trex2000/WifiBot/Academy Generated Requirement Specifications from Reqview/RC.html

# rc car

ID | Description | Discussion | Links
1 | 1 General Requirements Requirments describing the Robot
21 | 1.1 System Requirements Required features of the Robot | 2015-06-25: 123
17 | 1.1.1 Movement - Customer will provide chassis for the robot - Forward - Backward
24 | 1.1.1.1 Speed The speed of the engines will be variable starting from 0%, until 100%
25 | 1.1.1.1.1 Acceleration - incrementing 1% in every 100 milliseconds, the duty cycle will increase his value until 100% | 2015-06-25: My comment
26 | 1.1.1.1.2 Break - decrementing 2% in every 100 milliseconds, the duty cycle will decrease his value until 0%
27 | 1.1.1.1.3 No command - decrementing 1% in evert 100 milliseconds, the duty cycle will decrease his value until 0%
18 | 1.1.2 Direction The robot will have to perform the following movements: - Steering Left - Steering Right
28 | 1.1.2.1 Steering Left - while steering left is in action, the speed of the motor should be constant and equal to the current value
29 | 1.1.2.2 Steering Right - while steering right is in action, the speed of the motor should be constant and equal to the current value
23 | 1.1.3 Interface with ESP8266 The command will be sent form a web browser running on a separate Wifi module ESP8266
33 | 1.1.3.1 Communication The communication between the 2 modules (ESP8266 and Arduino UNO) will be performed through 4 separate GPIO port, each port corresponding to a direction (UP, DOWN, LEFT, RIGHT)
19 | 1.1.4 Signaling The robot will be equipped with 2 flashers on each side
30 | 1.1.4.1 Pulse generation - while steering left/right, the left/right signaling should activate, indicating the direction of the new path
31 | 1.1.4.2 Rhytm - 340 milliseconds on - 420 milliseconds off
20 | 1.1.5 Lighting The robot will be equipped with 2 LED lights that will be turned on when the light sensors status indicates DARK, will be switched off in case the light sensors indicate LIGHT
32 | 1.1.5.1 Light sensors - the robot will have a light sensor which will convert the light levels to a voltage with a range of 0-5 volts
14 | 1.2 Software Requirements Requirments related to software design and implementation
54 | 1.2.1 Hardware Abstraction Layer - will give the input/output functions to aplication
56 | 1.2.1.1 Inputs
59 | 1.2.1.1.1 SIA_LightSensor - range: 0 - 1023 - default value: 1023
60 | 1.2.1.1.2 SID_WifiControlUp - range: 0 - 1 - default value: 0
61 | 1.2.1.1.3 SID_WifiControlDown - range: 0 - 1 - default value: 0
62 | 1.2.1.1.4 SID_WifiControlRight - range: 0 - 1 - default value: 0
63 | 1.2.1.1.5 SID_WifiControlLeft - range: 0 - 1 - default value: 0
57 | 1.2.1.2 Outputs
64 | 1.2.1.2.1 SOD_Motor12_0 - range : 0 - 1 - default value: 0
65 | 1.2.1.2.2 SOD_Motor12_1 - range : 0 - 1 - default value: 0
66 | 1.2.1.2.3 SOD_Motor12_2 - range : 0 - 1 - default value: 0
67 | 1.2.1.2.4 SOD_Motor12_3 - range : 0 - 1 - default value: 0
68 | 1.2.1.2.5 SODPWM_EnableMotor1 - range : 0 - 100 (%) - default value: 0
69 | 1.2.1.2.6 SODPWM_EnableMotor2 - range : 0 - 100 (%) - default value: 0
70 | 1.2.1.2.7 SOD_LeftFlasher -range: 0 - 1 -default value : 0
71 | 1.2.1.2.8 SOD_RightFlasher -range: 0 - 1 -default value : 0
72 | 1.2.1.2.9 SOD_LowBeam -range: 0 - 1 -default value: 0
58 | 1.2.1.3 Functional requirements
92 | 1.2.1.3.1 Buffering The inputs and outputs will be placed inside 2 buffers, called inputBuffers and outputBuffers.
93 | 1.2.1.3.2 Interfaces 2 Interfaces shall be implemented between the APP <-> HAL: - A get() interface, which will be used to return the value of a logical pin (as described in chapter 1.2.1.1) - A set() interface, which will be used to set a request from the APP layer towards the HAL layer to update the physical output corresponding to the logical port, as described in chapter 1.2.1.2.
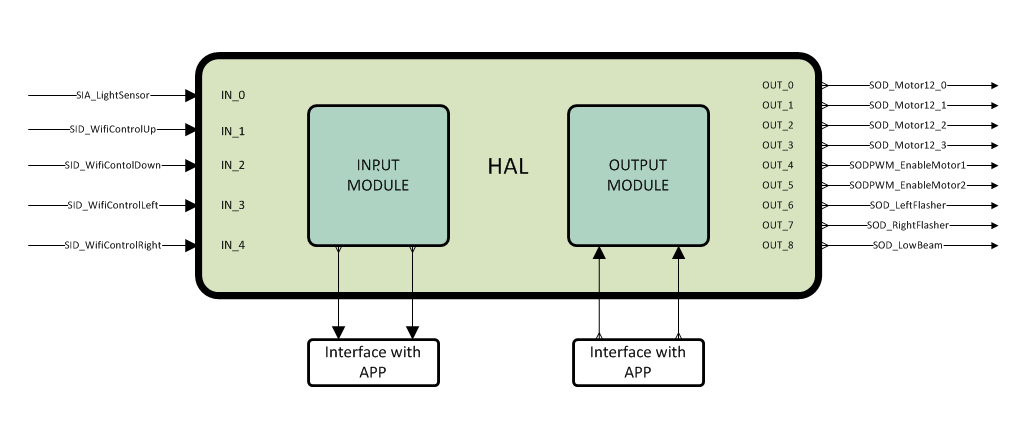
[picture p1: Academy Generated Requirement Specifications from Reqview/RC_files/80_1_hal.PNG]
80 | 1.2.1.4 Hardware Abstraction Layer  80_1_hal.PNG
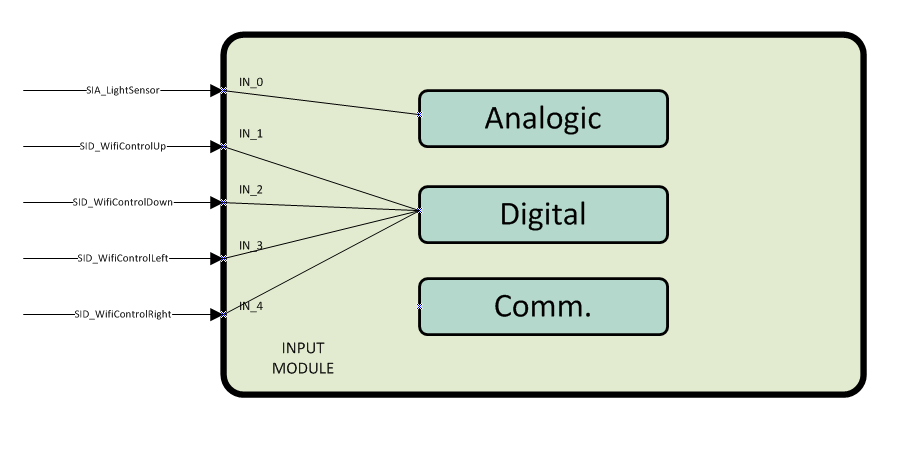
[picture p2: Academy Generated Requirement Specifications from Reqview/RC_files/81_1_input.PNG]
81 | 1.2.1.4.1 Inputs  81_1_input.PNG
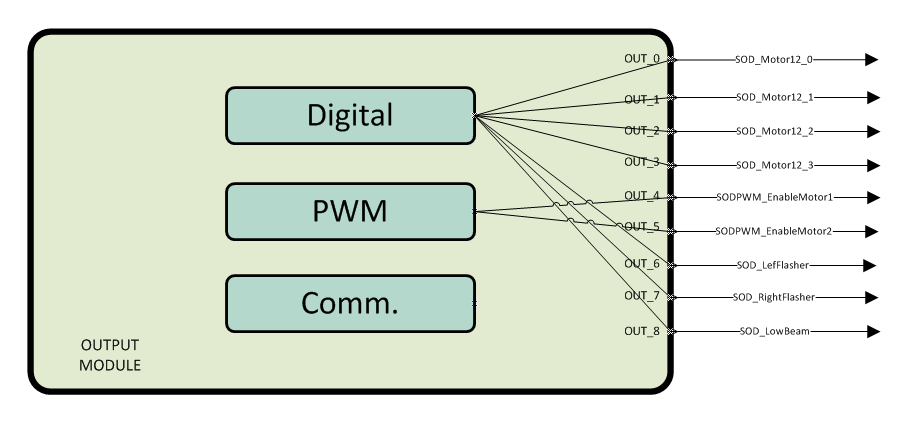
[picture p3: Academy Generated Requirement Specifications from Reqview/RC_files/82_1_output.PNG]
82 | 1.2.1.4.2 Outputs  82_1_output.PNG
76 | 1.2.2 Hardware Software Interface
77 | 1.2.2.1 Inputs SIA_Light Sensor – Arduino.A0 SID_WifiControlUp – Arduino.D7 SID_WifiControlDown – Arduino.D8 SID_WifiControlLeft – Arduino.D12 SID_WifiControlRight –Arduino.D13
78 | 1.2.2.2 Outputs SOD_Motor12_0 – Arduino.D10 SOD_Motor12_1 – Arduino.D9 SOD_Motor12_2 – Arduino.D5 SOD_Motor12_3 – Arduino.D4 SODPWM_EnableMotor1 – Arduino.D11 PWM SODPWM_EnableMotor2 – Arduino.D3 PWM SOD_LeftFlasher – Arduino.A2 ( must be set a digital pin) SOD_RightFlasher – Arduino.A1 ( must be set a digital pin) SOD_LowBeam – Arduino.D6
55 | 1.2.3 Application Software
11 | 1.3 Hardware Requirements All requirments related to: - hardware schematic - wiring - PCB design
36 | 1.3.1 Hardware Schematic
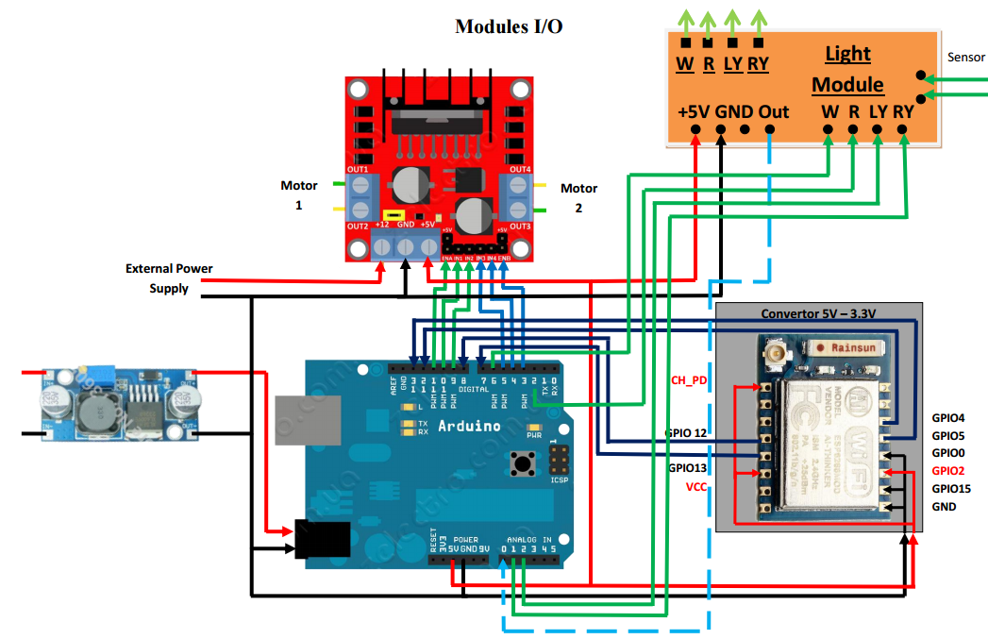
[picture p4: Academy Generated Requirement Specifications from Reqview/RC_files/37_1_wiring.png]
37 | 1.3.2 Wiring  37_1_wiring.png
38 | 1.3.3 PCB Design
39 | 1.3.4 Modules Informations regarding the modules used in project: - DC - DC Module - Arduino Module - ESP8266 Wi Fi module - Hbridge Module - Light Module
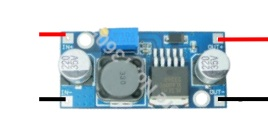
[picture p5: Academy Generated Requirement Specifications from Reqview/RC_files/40_1_dc-dc.jpg]
40 | 1.3.4.1 DC - DC Module  40_1_dc-dc.jpg
41 | 1.3.4.1.1 Inputs RED WIRE – The positive wire of the power supply BLACK WIRE – The ground wire of the power supply
43 | 1.3.4.1.2 Outputs RED WIRE – The positive wire for the 12V power circuit BLACK WIRE – The ground wire for the 12V power circuit
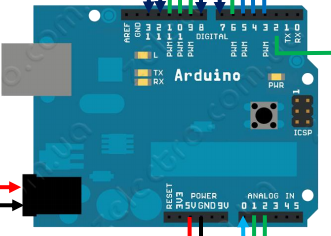
[picture p6: Academy Generated Requirement Specifications from Reqview/RC_files/44_1_arduino.jpg]
44 | 1.3.4.2 Arduino Uno Module  44_1_arduino.jpg
45 | 1.3.4.2.1 Inputs A0 – the value of the light sensor D7 – connects the GPIO13 pin of the Wi Fi module to the Arduino (Future Up button) D8 – connects the GPIO12 pin of the Wi Fi module to the Arduino (Future Down button) D12– connects the GPIO4 pin of the Wi Fi module to the Arduino (Future Left button) D13– connects the GPIO5 pin of the Wi Fi module to the Arduino (Future Right button) The power needed for powering the module will be provided from the DC – DC module output

46

1.3.4.2.2 Outputs

5V – power for the Wi – Fi Conversion module which will privide 3.3V for the pins: VCC, CH_PD and GPIO2

GND – ground reference for the Wi – Fi module pins: GPIO0, GPIO15 and GND

Analog pin 1 – connects with the RY pin on the Light Module,but it has to be set as a DIGITAL PIN

Analog pin 2 – connects with the LY pin on the Light Module,but it has to be set as a DIGITAL PIN

Digital pin 2 – connects with the R pin on the Light Module

Digital pin 3 – connects with the ENB pin on the Hbridge Module, this pin needs to be a PWM pin.

Digital pin 4 – connects with the Hbridge pin IN4, is not necessarly to be a pwm pin.

Digital pin 5 – connects with the Hbridge pin IN3, is not necessarly to be a pwm pin.

Digital pin 6 – connects with the W pin on the Light Module

Digital pin 9 – connects with the Hbridge pin IN2, is not necessarly to be a pwm pin.

Digital pin 10 – connects with the Hbridge pin IN1, is not necessarly to be a pwm pin.

Digital pin 11 – connects with the ENA pin on the Hbridge Module, this pin needs to be a PWM pin.
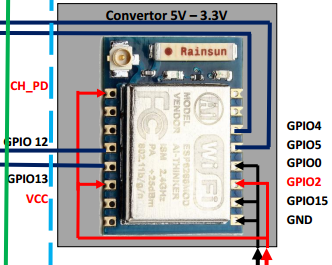
[picture p7: Academy Generated Requirement Specifications from Reqview/RC_files/47_1_wifi.jpg]
47 | 1.3.4.3 ESP8266 WiFi module  47_1_wifi.jpg
48 | 1.3.4.3.1 Inputs CH_PD – connects with the 3.3v pin on the Conversion Module VCC – connects with the 3.3v pin on the Conversion Module GPIO2 – connects with the 3.3v pin on the Conversion Module GPIO0 – connects with the GND pin on the Arduino Module GPIO15 – connects with the GND pin on the Arduino Module GND – connects with the GND pin on the Arduino Module
49 | 1.3.4.3.1.1 Outputs GPIO4 – connects with the arduino module on digital pin 12 (Future Left ) GPIO5 – connects with the arduino module on digital pin 13 (Future Right) GPIO12 – connects with the arduino module on digital pin 8 (Future Down) GPIO13 – connects with the arduino module on digital pin 7 (Future Up)
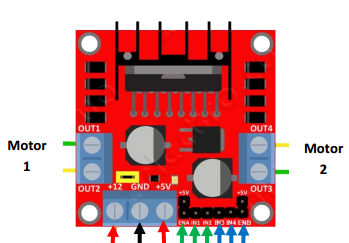
[picture p8: Academy Generated Requirement Specifications from Reqview/RC_files/50_1_hbridge.jpg]
50 | 1.3.4.4 Hbridge Module  50_1_hbridge.jpg

51

1.3.4.4.1 Inputs

+12 V – the external power supply positive wire will be connected to this pin

GND – the external power supply negative wire will be connected to this pin

ENA – connects with the D11 pin on the Arduino module, this input needs to be a PWM signal.

IN1 – connects with the D10 pin on the Arduino module, not necessarly to be a PWM pin.

IN2 – connects with the D9 pin on the Arduino module, not necessarly to be a PWM pin.

IN3 – connects with the D5 pin on the Arduino module, not necessarly to be a PWM pin.

IN4 – connects with the D4 pin on the Arduino module, not necessarly to be a PWM pin.

ENB – connects with the D3 pin on the Arduino module, this input needs to be a PWM signal.
53 | 1.3.4.4.2 Outputs OUT1 – connects the first wire of the first DC motor. OUT2 – connects the second wire of the first DC motor. OUT3 – connects the first wire of the second DC motor. OUT4 – connects the second wire of the second DC motor
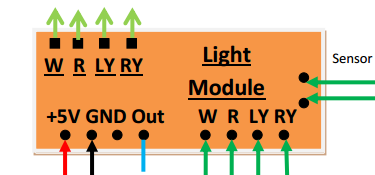
[picture p9: Academy Generated Requirement Specifications from Reqview/RC_files/73_1_lightModule.png]
73 | 1.3.4.5 Light Module  73_1_lightModule.png
74 | 1.3.4.5.1 Inputs +5V – the 5V wire will be connected to this pin GND – the GND wire will be connected to this pin Sensor in – this pins will be connected to the actual sensor W – this pin controls the Low Beam output R - this pin controls the Stop output LY - this pin controls the Left Signaling output RY - this pin controls the Right Signaling output
75 | 1.3.4.5.2 Outputs W – this pin controls the Low Beam LEDS R - this pin controls the Stop LEDS LY - this pin controls the Left Signaling LEDS RY - this pin controls the Right Signaling LEDS
13 | 1.4 Mechanical Design Mechanical aspects
83 | 1.4.1 Module distribution
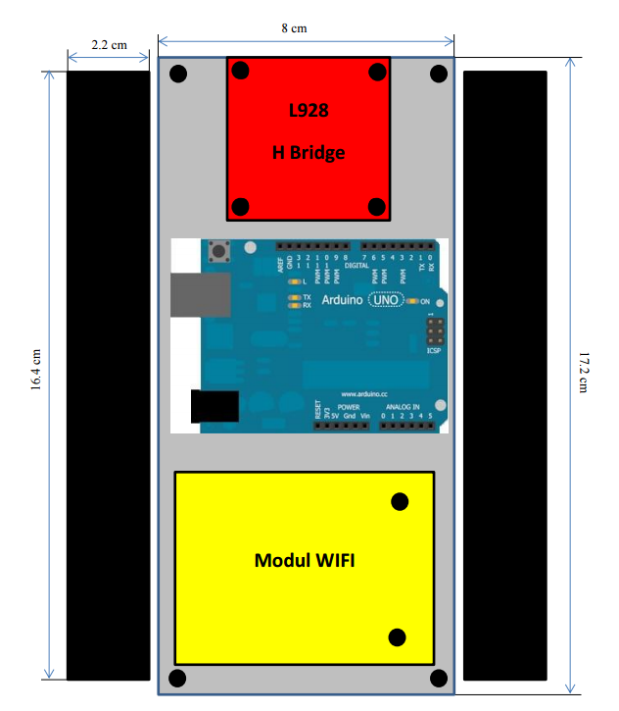
[picture p10: Academy Generated Requirement Specifications from Reqview/RC_files/85_1_top.png]
85 | 1.4.1.1 Top of the board Above the board are displayed three modules - H bridge - Arduino Uno - Wifi Module  85_1_top.png
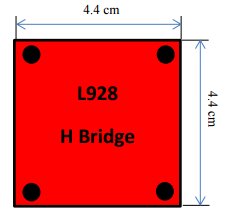
[picture p11: Academy Generated Requirement Specifications from Reqview/RC_files/87_1_hbridgesize.png]
87 | 1.4.1.1.1 HBridge Module  87_1_hbridgesize.png
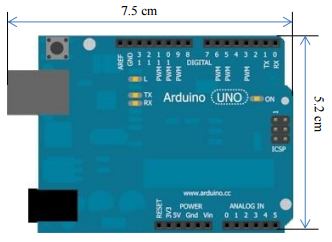
[picture p12: Academy Generated Requirement Specifications from Reqview/RC_files/88_1_arduinosize.png]
88 | 1.4.1.1.2 Arduino Uno  88_1_arduinosize.png
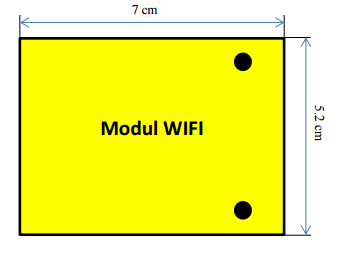
[picture p13: Academy Generated Requirement Specifications from Reqview/RC_files/89_1_wifiModule.png]
89 | 1.4.1.1.3 WiFi Module  89_1_wifiModule.png
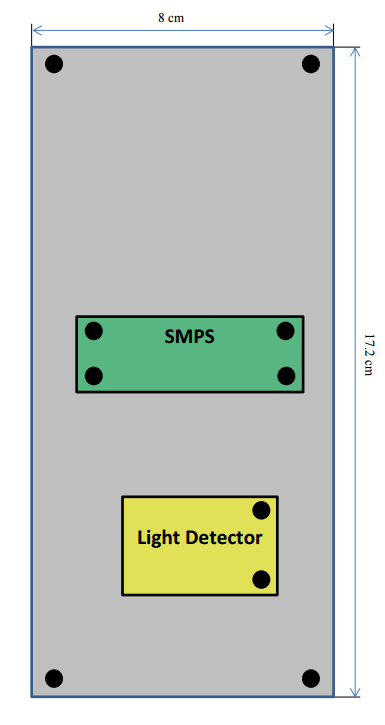
[picture p14: Academy Generated Requirement Specifications from Reqview/RC_files/86_1_bottom.png]
86 | 1.4.1.2 Bottom of the board Underneath the board are displayed two modules - Light Module - Boost Power Supply Converter Module  86_1_bottom.png
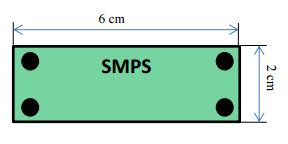
[picture p15: Academy Generated Requirement Specifications from Reqview/RC_files/90_1_smpssize.png]
90 | 1.4.1.2.1 Boost Power Supply Converter Module  90_1_smpssize.png
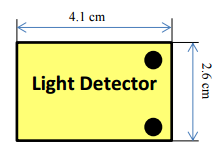
[picture p16: Academy Generated Requirement Specifications from Reqview/RC_files/91_1_lightDetectorsize.png]
91 | 1.4.1.2.2 Light Detector  91_1_lightDetectorsize.png
84 | 1.4.2 Bill of Materials - RP5RP6-Roboter (https://webmail.arobs.com/owa/redir.aspx) chasis - Arduino Uno Board - WiFi Module ESP8266 - Power Supply Converter - Dual H bridge - 30 bold nut (3mm) - 15 screw bolt (3mm) - 4 pedestals for LEDs - 2 white LEDs - 2 red LEDs - 4 Orange LEDs
9 | 2 Test Cases
10 | 2.1 Inputs
34 | 2.2 Expected Values Test Output Test inputs

Last modified by Barna Peto, Arobs on 2015-07-14 12:05
