trex2000/WifiBot/(commit log)

2016-02-19 Added ADC processing
2016-02-22 Added motor states
2017-11-16 break lights pwm controlled 0 - off 50 - when low light 99 - when break pedal pushed
2017-11-16 Changed motor direction
2017-11-16 Changed pwm max value form 256 to 255
2017-11-21 Tested light sensor
2017-11-21 Raspberry web interface added
2017-11-22 Renamed motor variables
2017-11-22 Added touch functions to buttons for mobile web pages
2017-11-22 Rewrited motor library
2017-11-24 Moved motorCyclic to task20ms for task40ms
2018-01-03 Raspberry pi setup file
